SavannahLB/Vending-Machine/Schematics/Button Schematic.png

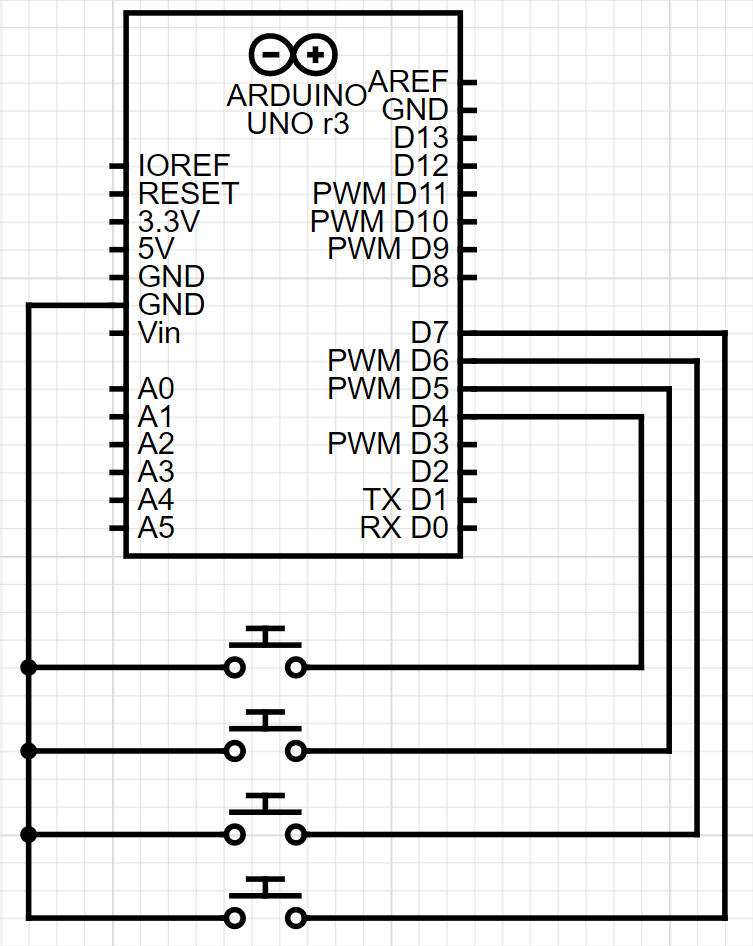
Schematics/Button Schematic.png
