SavannahLB/Vending-Machine/Schematics/LCD Schematic.png

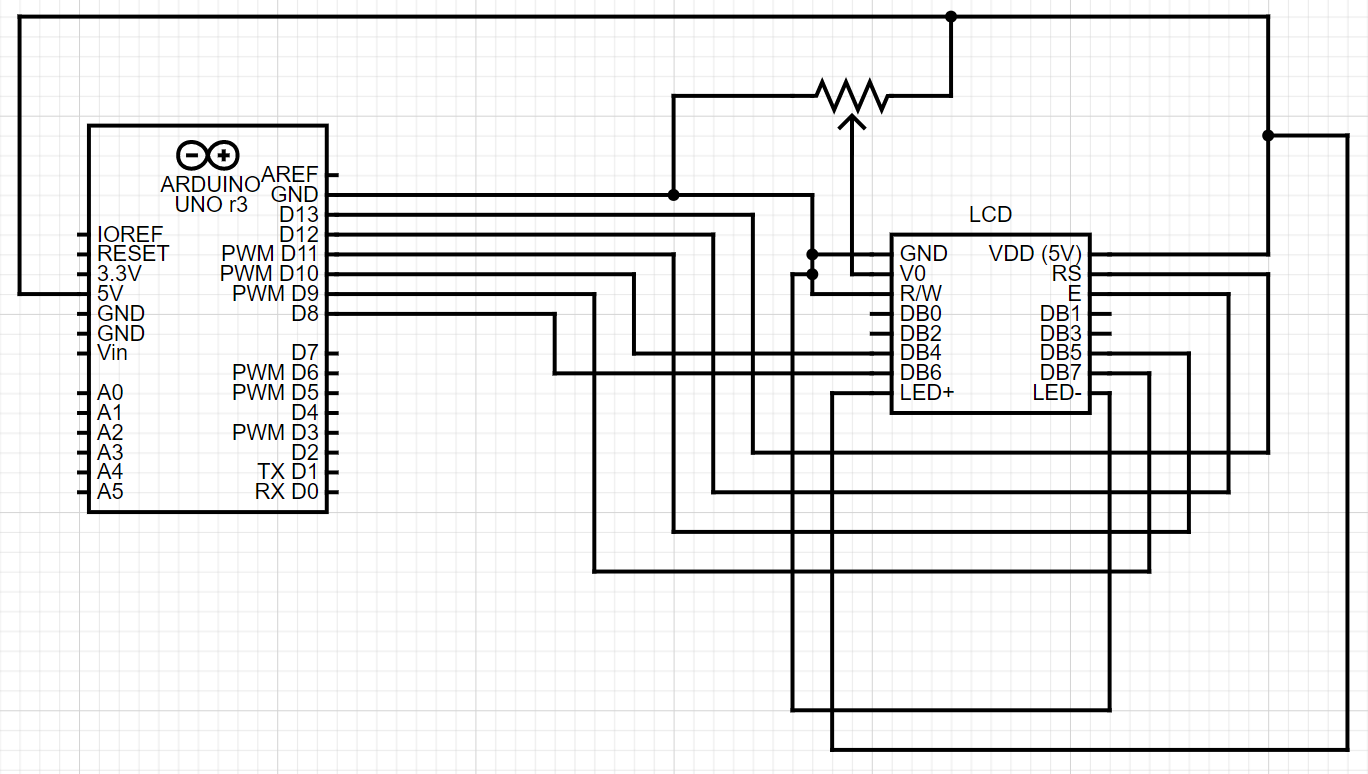
Schematics/LCD Schematic.png
