SavannahLB/Vending-Machine/Schematics/Motor 1 Schematic.png

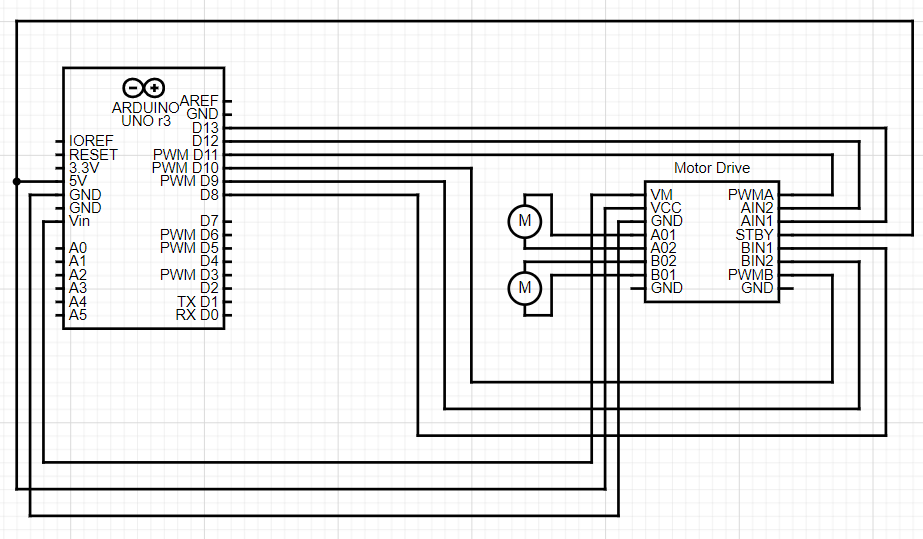
Schematics/Motor 1 Schematic.png
