SavannahLB/Vending-Machine/Schematics/Motor 2 Schematic.png

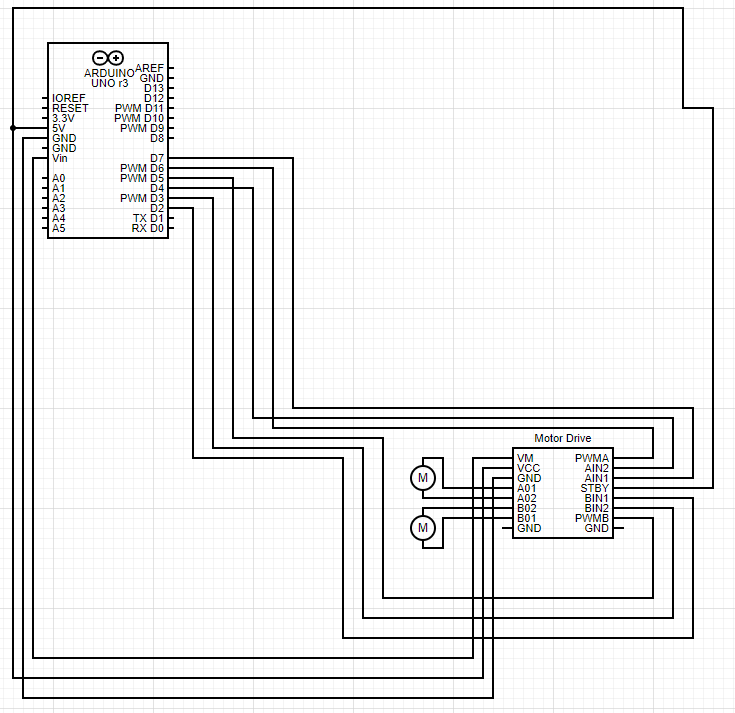
Schematics/Motor 2 Schematic.png
